Minato-J/EDT/README.md

# 2026 年全国大学生电子设计竞赛 — 智能小车循迹系统

## 📋 项目概述

本项目为 2026 年全国大学生电子设计竞赛（武汉工程大学校内选拔赛）智能小车参赛作品。小车以 **STM32F407VET6** 为主控芯片，**K230 摄像头模组**进行视觉循迹，**JY901S 陀螺仪**实现姿态保持与航向角闭环控制，通过 **TB6612** 双路电机驱动芯片控制双轮差速小车，沿指定路线自动行驶。

### 赛道场地布局

```
                          A ——————————— B
                         /                \
                        /                  \
                       /                    \
                      |                      |
                      |      场地尺寸          |
                      |   220cm × 120cm      |
                      |   圆弧半径 R=40cm     |
                      |                      |
                       \                    /
                        \                  /
                         \                /
                          D ——————————— C
```

| 参数 | 数值 |
|---|---|
| 外框总长度 | 220 cm |
| 外框总宽度 | 120 cm |
| 圆弧半径 | 40 cm |
| 顶部直线 AB 距离 | 100 cm |
| 圆心距边界 | 右侧圆心距右边界 60cm，距下边界 60cm（中轴线上） |

### 竞赛任务

| 任务 | 路线 | 状态 |
|---|---|:----:|
| 任务(1) | A→B 直线行驶 | ✅ 已完成 |
| 任务(2) | A→B→C→D→A 完整一圈 | 🔧 框架已搭建 (~40%) |
| 任务(3) | A→C→B→D→A 交叉路径 | 🔧 初期开发 (~10%) |
| 任务(4) | 多圈连续行驶 + 精确停车 | ⏳ 未开始 (0%) |

---

## 🧩 系统总体框图

```
┌──────────────────────────────────────────────────────────────────────────┐
│                            系统总体架构                                    │
└──────────────────────────────────────────────────────────────────────────┘

┌──────────────────┐                         ┌──────────────────┐
│   K230 摄像头     │                         │   JY901S 陀螺仪   │
│   视觉感知模块     │                         │   姿态感知模块     │
│                  │                         │                  │
│  • 640×480 RGB   │    UART3 (115200bps)    │  • 3轴加速度计    │    UART2 (9600bps)
│  • 6路ROI灰度检测 │ ◄──────────────────────►│  • 3轴陀螺仪      │ ◄──────────────────────►
│  • 黑线阈值=30   │    3字节数据包           │  • 3轴角度(RPY)   │    11字节数据包
│  • MicroPython   │    [0xAA,0x55,data]     │  • 波特率9600     │    [0x55,type,6B+chk]
└──────────────────┘                         └──────────────────┘
         │                                            │
         │  6-bit 黑线位图                            │  Yaw/Roll/Pitch 角度
         │  (每bit代表1路ROI的黑/白)                    │
         │                                            │
         ▼                                            ▼
┌──────────────────────────────────────────────────────────────────────────┐
│                        STM32F407VET6 主控制器                             │
│                        ARM Cortex-M4 @ 168MHz                            │
│                                                                          │
│  ┌─────────────────────────────────────────────────────────────────┐   │
│  │                     TIM6 中断服务程序 (20ms)                       │   │
│  │                                                                   │   │
│  │  ┌──────────┐  ┌──────────┐  ┌──────────┐  ┌──────────┐        │   │
│  │  │ 按键扫描  │  │ 节点检测  │  │ 角度过滤  │  │ 双模切换  │        │   │
│  │  │ (PB0/PC12)│  │ (黑线边沿)│  │ (>30°丢弃)│  │ 策略选择  │        │   │
│  │  └──────────┘  └──────────┘  └──────────┘  └────┬─────┘        │   │
│  │                                                 │               │   │
│  │                    ┌────────────────────────────┴──────┐        │   │
│  │                    │  line_sensor_data                  │        │   │
│  │                    ▼                                    ▼        │   │
│  │        ┌──────────────────┐              ┌──────────────────┐    │   │
│  │        │  模式A: 盲开模式  │              │  模式B: 循迹模式  │    │   │
│  │        │  (无黑线可见时)   │              │  (检测到黑线时)   │    │   │
│  │        │  target_angle    │              │  K230转弯量+      │    │   │
│  │        │  驱动角度环PID    │              │  速度环PID修正    │    │   │
│  │        └────────┬─────────┘              └────────┬─────────┘    │   │
│  │                 │                                 │              │   │
│  │                 └────────────┬────────────────────┘              │   │
│  │                              ▼                                    │   │
│  │              ┌─────────────────────────────┐                     │   │
│  │              │  增量式 PID 速度环 × 2        │                     │   │
│  │              │  左轮: Kp=0.9 Ki=0.12        │                     │   │
│  │              │  右轮: Kp=0.8 Ki=0.12        │                     │   │
│  │              │  + 角度环 PD (Kp=0.8 Kd=0.9) │                     │   │
│  │              └──────────────┬──────────────┘                     │   │
│  │                             │                                    │   │
│  │              ┌──────────────┴──────────────┐                     │   │
│  │              │  编码器速度反馈 (低通滤波)    │                     │   │
│  │              │  filtered=0.7×prev+0.3×raw  │                     │   │
│  │              └─────────────────────────────┘                     │   │
│  └─────────────────────────────────────────────────────────────────┘   │
│                                                                          │
│  ┌──────────────────────────────────────────────────────────────────┐   │
│  │                      任务状态机 (主循环)                           │   │
│  │  Task1: count触发  │  Task2: count触发  │  Task3: state机(9态)   │   │
│  │  A→B直线→停车      │  A→B→C→D→A一圈     │  A→C→B→D→A交叉        │   │
│  └──────────────────────────────────────────────────────────────────┘   │
└──────────────────────────────────────────────────────────────────────────┘
         │                                │
         │ PWM (PA6/PA7)                  │ 编码器脉冲
         │ TIM3 CH1/CH2                   │ TIM2(左) TIM4(右)
         │ 20kHz                          │ 4倍频计数
         ▼                                ▼
┌──────────────────────────────────────────────────────────────────────────┐
│                          电机驱动与执行层                                  │
│                                                                          │
│  ┌──────────────┐   ┌──────────────┐   ┌──────────────┐                 │
│  │  TB6612 驱动  │   │  左轮电机     │   │  右轮电机     │                 │
│  │  STBY + AINx  │   │  TT直流电机   │   │  TT直流电机   │                 │
│  │  + BINx + PWM │   │  编码器 ×2    │   │  编码器 ×2    │                 │
│  └──────────────┘   └──────────────┘   └──────────────┘                 │
│                                                                          │
│  ┌──────────────┐   ┌──────────────┐   ┌──────────────┐                 │
│  │  OLED 显示    │   │  LED + 蜂鸣器 │   │  按键输入     │                 │
│  │  软件I2C      │   │  状态指示     │   │  任务选择/启动 │                 │
│  │  PB6/PB7      │   │  PC9/PD3     │   │  PB0/PC12    │                 │
│  └──────────────┘   └──────────────┘   └──────────────┘                 │
└──────────────────────────────────────────────────────────────────────────┘
```

---

## ⚙️ 电机驱动子系统

### 子系统框图

```
┌─────────────────────────────────────────────────────────────────────┐
│                       电机驱动子系统架构                               │
└─────────────────────────────────────────────────────────────────────┘

                        ┌──────────────────────┐
                        │   STM32F407VET6      │
                        │   主控制器             │
                        │                      │
                        │  ┌────────────────┐  │
                        │  │  PID 速度环     │  │
                        │  │  left  right   │  │
                        │  │  输出: ±500    │  │
                        │  └───┬────────┬───┘  │
                        │      │        │      │
                        │  ┌───┴──┐ ┌──┴────┐  │
                        │  │ PWM  │ │ PWM   │  │
                        │  │ CH1  │ │ CH2   │  │
                        │  │ PA6  │ │ PA7   │  │
                        │  └──┬───┘ └──┬────┘  │
                        └─────┼────────┼───────┘
                              │        │
                    ┌─────────┼────────┼─────────┐
                    │         ▼        ▼         │
                    │  ┌─────────────────────┐   │
                    │  │     TB6612FNG       │   │
                    │  │   双路H桥电机驱动    │   │
                    │  │                     │   │
      VM (7.4V) ────┤──│ VM          VCC ────┼───┤── 5V (STM32)
                    │  │                     │   │
                    │  │ PWMA ─── PA6 (TIM3) │   │
                    │  │ AIN1 ─── PE2 (GPIO) │   │
                    │  │ AIN2 ─── PE3 (GPIO) │   │
                    │  │                     │   │
                    │  │ PWMB ─── PA7 (TIM3) │   │
                    │  │ BIN1 ─── PE4 (GPIO) │   │
                    │  │ BIN2 ─── PE5 (GPIO) │   │
                    │  │                     │   │
                    │  │ STBY ─── PE6 (GPIO) │   │
                    │  │ GND ──── GND        │   │
                    │  └────────┬────────────┘   │
                    │           │                │
                    │     ┌─────┴─────┐          │
                    │     ▼           ▼          │
                    │  ┌──────┐  ┌──────┐        │
                    │  │ 左轮  │  │ 右轮  │        │
                    │  │ M1    │  │ M2    │        │
                    │  │ TT电机│  │ TT电机│        │
                    │  └──┬───┘  └──┬───┘        │
                    │     │         │            │
                    │  ┌──┴─────────┴──┐         │
                    │  │  霍尔编码器    │         │
                    │  │  A相 + B相     │         │
                    │  └──┬─────────┬──┘         │
                    │     │         │            │
                    └─────┼─────────┼────────────┘
                          │         │
                    ┌─────┼─────────┼────────────┐
                    │     ▼         ▼            │
                    │  TIM2_CH1  TIM4_CH1        │
                    │  PA0       PD12            │
                    │  TIM2_CH2  TIM4_CH2        │
                    │  PA1       PD13            │
                    │  STM32 编码器接口           │
                    │  4倍频 脉冲计数             │
                    └────────────────────────────┘
```

### 电机驱动电路原理图

```
                        TB6612FNG 电机驱动电路
                        ═══════════════════════

                              VM (电池 7.4V)
                               │
                              ─┼─ C1
                              ─┼─ 100μF/25V
                               │ 电解电容
                              ─┼─ C2
                              ─┼─ 0.1μF
                               │ 陶瓷电容
                               │
            ┌──────────────────┼──────────────────────┐
            │                  │                      │
            │    ┌─────────────┴─────────────┐        │
            │    │          TB6612FNG         │        │
            │    │                            │        │
    5V ─────┼────│ 1  VCC           VM    24 │────────┼── VM
            │    │                            │        │
    5V ─────┼────│ 2  VCC           GND   23 │────────┼── GND
            │    │                            │        │
    GND ────┼────│ 3  GND          PWMB   22 │────────┼── PA7 (TIM3_CH2)
            │    │                            │        │
            │    │                   BIN2  21 │────────┼── PE5
 PA6 ──────┼────│ 4  PWMA          BIN1  20 │────────┼── PE4
 (TIM3_CH1)│    │                            │        │
            │    │                   STBY  19 │────────┼── PE6
 PE2 ──────┼────│ 5  AIN1           VCC   18 │────────┼── 5V
            │    │                            │        │
 PE3 ──────┼────│ 6  AIN2           GND   17 │────────┼── GND
            │    │                            │        │
            │    │                  AO2   16 │────────┼── 左电机 (+)
  左电机 ───┼────│ 7  AO1           AO2   15 │────────┼── 左电机 (-)
  M1       │    │                            │        │
            │    │                  BO2   14 │────────┼── 右电机 (+)
  右电机 ───┼────│ 8  BO1           BO2   13 │────────┼── 右电机 (-)
  M2       │    │                            │        │
            │    │                  GND   12 │────────┼── GND
            │    │                  VM    11 │────────┼── VM
            │    └────────────────────────────┘        │
            │                                          │
            └──────────────────────────────────────────┘

            控制真值表:
            ╔══════╤══════╤══════╤══════════════╗
            ║ AIN1 │ AIN2 │ PWMA │  电机状态     ║
            ╠══════╪══════╪══════╪══════════════╣
            ║  1   │  0   │  X   │  正转 (前进)  ║
            ║  0   │  1   │  X   │  反转 (后退)  ║
            ║  0   │  0   │  X   │  刹车         ║
            ║  1   │  1   │  X   │  刹车         ║
            ╚══════╧══════╧══════╧══════════════╝

            STBY = 1: 正常工作
            STBY = 0: 待机(电机停转)

            PWM频率: 20kHz (TIM3: PSC=83, ARR=99, 168MHz/84/100)
```

### 编码器速度反馈电路

```
                     编码器接口电路
                     ═══════════════

    左轮编码器                            右轮编码器
    ┌─────────┐                          ┌─────────┐
    │ 霍尔编码器│                          │ 霍尔编码器│
    │ A相  B相 │                          │ A相  B相 │
    └──┬───┬──┘                          └──┬───┬──┘
       │   │                                │   │
       ▼   ▼                                ▼   ▼
    ┌──────────┐                         ┌──────────┐
    │ 上拉电阻  │                         │ 上拉电阻  │
    │ 10kΩ ×2  │                         │ 10kΩ ×2  │
    └────┬─────┘                         └────┬─────┘
         │                                    │
    ┌────┴────┐                          ┌────┴────┐
    ▼         ▼                          ▼         ▼
   PA0      PA1                        PD12      PD13
  TIM2_CH1 TIM2_CH2                  TIM4_CH1  TIM4_CH2
    │         │                          │         │
    └────┬────┘                          └────┬────┘
         ▼                                    ▼
    ┌──────────────────┐              ┌──────────────────┐
    │ TIM2 编码器模式    │              │ TIM4 编码器模式    │
    │ TI12 4倍频        │              │ TI12 4倍频        │
    │ 周期=20ms读取一次  │              │ 周期=20ms读取一次  │
    │ 读后清零          │              │ 读后清零          │
    └──────────────────┘              └──────────────────┘
         │                                    │
         └────────────┬───────────────────────┘
                      ▼
              ┌───────────────┐
              │ 低通滤波       │
              │ filt = 0.7×old│
              │      + 0.3×new│
              └───────┬───────┘
                      ▼
              ┌───────────────┐
              │ PID 速度环输入 │
              │  target vs    │
              │  filtered     │
              └───────────────┘
```

### 电机驱动关键参数

| 参数 | 数值 | 说明 |
|---|:----:|---|
| PWM 频率 | 20 kHz | 超声频段，无啸叫 |
| PWM 分辨率 | 100 级 | ARR=99，占空比 1% 步进 |
| 速度输出范围 | -1000 ~ +1000 | 软件钳位，正=前进 |
| 左轮 PID Kp | 0.9 | 速度环比例增益 |
| 左轮 PID Ki | 0.12 | 速度环积分增益 |
| 右轮 PID Kp | 0.8 | 速度环比例增益 |
| 右轮 PID Ki | 0.12 | 速度环积分增益 |
| 角度环 Kp | 0.8 | 航向角比例增益 |
| 角度环 Kd | 0.9 | 航向角微分增益 |
| 编码器分辨率 | 4倍频 | TI12模式，双通道双沿 |

---

## 👁️ 视觉循迹子系统

### 子系统框图

```
┌─────────────────────────────────────────────────────────────────────┐
│                      视觉循迹子系统架构                               │
└─────────────────────────────────────────────────────────────────────┘

┌─────────────────────────────────────────────────────┐
│                  K230 摄像头模组                      │
│                                                     │
│  ┌───────────────────────────────────────────────┐  │
│  │             OV5647 图像传感器                   │  │
│  │            1280×960 → 640×480 RGB565          │  │
│  └────────────────────┬──────────────────────────┘  │
│                       │                              │
│                       ▼                              │
│  ┌───────────────────────────────────────────────┐  │
│  │          MicroPython 图像处理流水线              │  │
│  │                                               │  │
│  │   640×480 画面分割为 6 个 ROI 区域:             │  │
│  │                                               │  │
│  │  ┌──────┬──────┬──────┬──────┬──────┬──────┐  │  │
│  │  │ ROI0 │ ROI1 │ ROI2 │ ROI3 │ ROI4 │ ROI5 │  │  │
│  │  │ 106px│ 106px│ 106px│ 106px│ 106px│ 110px│  │  │
│  │  │      │      │      │      │      │      │  │  │
│  │  │ 位5  │ 位4  │ 位3  │ 位2  │ 位1  │ 位0  │  │  │
│  │  │ MSB  │      │      │      │      │ LSB  │  │  │
│  │  └──────┴──────┴──────┴──────┴──────┴──────┘  │  │
│  │         y=360, h=60px (画面下部)               │  │
│  │                                               │  │
│  │  每个 ROI: 计算平均灰度 → 阈值判断(30)          │  │
│  │  灰度 < 30 → 黑线 → bit=1                      │  │
│  │  灰度 ≥ 30 → 白底 → bit=0                      │  │
│  └────────────────────┬──────────────────────────┘  │
│                       │                              │
│                       ▼                              │
│  ┌───────────────────────────────────────────────┐  │
│  │        UART 发送 (115200bps, 8N1)             │  │
│  │        3字节数据包: [0xAA, 0x55, data]         │  │
│  │        data = 6-bit 黑线位图                   │  │
│  └────────────────────┬──────────────────────────┘  │
│                       │                              │
│  ┌────────────────────┴──────────────────────────┐  │
│  │        ST7701 2.4" LCD 显示屏                  │  │
│  │        实时预览: 绿色=黑线, 红色=白底           │  │
│  └───────────────────────────────────────────────┘  │
└─────────────────────┬───────────────────────────────┘
                      │
          UART3 (115200bps, 8N1)
          PB10 (STM32 RX) ← PB11 (STM32 TX)
          K230 TX → STM32 RX
                      │
                      ▼
┌─────────────────────────────────────────────────────┐
│              STM32F407VET6 视觉数据处理               │
│                                                     │
│  ┌───────────────────────────────────────────────┐  │
│  │   UART3 RX 中断 (逐字节接收)                    │  │
│  │   状态机:                                       │  │
│  │   WAIT_AA → WAIT_55 → GET_DATA → WAIT_AA      │  │
│  │   接收到 data 字节后更新 line_sensor_data       │  │
│  └────────────────────┬──────────────────────────┘  │
│                       │                              │
│                       ▼                              │
│  ┌───────────────────────────────────────────────┐  │
│  │        K230_Get_Turn_Speed()                  │  │
│  │        6-bit 位图 → 转弯量映射                  │  │
│  │                                               │  │
│  │  ┌─────────────┬──────────┬────────────────┐  │  │
│  │  │  sensor_val │  含义    │  turn_speed    │  │  │
│  │  ├─────────────┼──────────┼────────────────┤  │  │
│  │  │   0x0C      │ 正中     │      0         │  │  │
│  │  │   0x08      │ 略左偏   │     +2         │  │  │
│  │  │   0x04      │ 略右偏   │     -2         │  │  │
│  │  │   0x18      │ 中度左偏 │     +3         │  │  │
│  │  │   0x06      │ 中度右偏 │     -3         │  │  │
│  │  │   0x1C      │ 中左偏   │     +5         │  │  │
│  │  │   0x0E      │ 中右偏   │     -5         │  │  │
│  │  │   0x38      │ 强左偏   │     +6         │  │  │
│  │  │   0x07      │ 强右偏   │     -6         │  │  │
│  │  │   0x30      │ 极左偏   │    +10         │  │  │
│  │  │   0x03      │ 极右偏   │    -10         │  │  │
│  │  │   0x20      │ 最左边缘 │    +12         │  │  │
│  │  │   0x01      │ 最右边缘 │    -12         │  │  │
│  │  │   default   │ 保持上次 │  last_turn     │  │  │
│  │  └─────────────┴──────────┴────────────────┘  │  │
│  └────────────────────┬──────────────────────────┘  │
│                       │                              │
│                       ▼                              │
│  ┌───────────────────────────────────────────────┐  │
│  │        双模切换逻辑 (TIM6 中断内)               │  │
│  │                                               │  │
│  │  line_sensor_data == 0x00 ?                   │  │
│  │    ├─ YES → 模式A (盲开):                      │  │
│  │    │   角度环PID保持 target_angle               │  │
│  │    │   turn_out = angle_PID_output             │  │
│  │    │                                           │  │
│  │    └─ NO  → 模式B (循迹):                      │  │
│  │       turn_out = K230_Get_Turn_Speed(data)     │  │
│  │       转弯平滑: 0.7×old + 0.3×new              │  │
│  │       target_v_left  = base_speed - turn       │  │
│  │       target_v_right = base_speed + turn       │  │
│  └───────────────────────────────────────────────┘  │
└─────────────────────────────────────────────────────┘
```

### K230 视觉处理电路原理图

```
                    K230 摄像头模组接线图
                    ═════════════════════

┌─────────────────────────────────────────────────────────────────┐
│                      K230 开发板                                 │
│                                                                 │
│   ┌───────────────────────────────────────────────────────────┐ │
│   │                    K230 芯片 (RISC-V + KPU)                 │ │
│   │                                                           │ │
│   │  ┌────────────────┐        ┌────────────────┐            │ │
│   │  │  OV5647 摄像头   │  CSI   │  图像处理流水线  │            │ │
│   │  │  640×480@30fps  │───────►│  6×ROI 灰度检测 │            │ │
│   │  └────────────────┘        └───────┬────────┘            │ │
│   │                                    │                      │ │
│   │                          ┌─────────┴─────────┐            │ │
│   │                          ▼                     ▼          │ │
│   │                   ┌────────────┐       ┌────────────┐     │ │
│   │                   │ UART 发送   │       │ LCD 显示    │     │ │
│   │                   │ 115200bps  │       │ ST7701 2.4"│     │ │
│   │                   │ TX         │       │ 实时预览    │     │ │
│   │                   └─────┬──────┘       └────────────┘     │ │
│   │                         │                                  │ │
│   └─────────────────────────┼──────────────────────────────────┘ │
│                             │                                    │
│                   K230 TX   │   K230 RX                          │
│                     (发送)   │   (接收)                           │
│                       │     │     │                              │
└───────────────────────┼─────┼─────┼──────────────────────────────┘
                        │     │     │
                        │     │     │
        ┌───────────────┼─────┼─────┼───────────────┐
        │               ▼     │     ▼               │
        │         PB10 (RX)   │   PB11 (TX)         │
        │               │     │     │               │
        │         ┌─────┴─────┼─────┴─────┐         │
        │         │   UART3    │   UART3   │         │
        │         │   RX中断   │   TX      │         │
        │         │  (115200)  │ (115200)  │         │
        │         └───────────┘ └──────────┘         │
        │                  STM32F407VET6              │
        └────────────────────────────────────────────┘

        通信协议:
        ╔═══════╤═══════╤═════════════╤══════════════════════╗
        ║ Byte0 │ Byte1 │   Byte2     │        说明           ║
        ╠═══════╪═══════╪═════════════╪══════════════════════╣
        ║ 0xAA  │ 0x55  │ sensor_data │ 帧头固定, data=6位位图 ║
        ╚═══════╧═══════╧═════════════╧══════════════════════╝

        data 位定义:
        ╔═══════╤═══════╤═══════╤═══════╤═══════╤═══════╗
        ║ Bit 5 │ Bit 4 │ Bit 3 │ Bit 2 │ Bit 1 │ Bit 0 ║
        ║ ROI 0 │ ROI 1 │ ROI 2 │ ROI 3 │ ROI 4 │ ROI 5 ║
        ║ 最左  │       │       │       │       │ 最右  ║
        ╚═══════╧═══════╧═══════╧═══════╧═══════╧═══════╝
        1 = 检测到黑线, 0 = 白底
```

### 视觉循迹关键参数

| 参数 | 数值 | 说明 |
|---|:----:|---|
| 图像分辨率 | 640×480 | RGB565 格式 |
| ROI 数量 | 6 路 | 均匀分布画面下方 |
| ROI 尺寸 | 106×60 px | 每路 (最右 110px) |
| ROI Y 位置 | y=360 | 画面下方 3/4 处 |
| 黑线阈值 | 30 | 平均灰度 < 30 判定为黑 |
| 通信波特率 | 115200 bps | UART3 |
| 数据包长度 | 3 字节 | [0xAA, 0x55, data] |
| 转弯量范围 | -12 ~ +12 | 正值=左转，负值=右转 |
| 转弯平滑系数 | 0.3 | 一阶低通滤波 |
| 盲开判定条件 | data == 0x00 | 所有 ROI 均为白色 |

---

## 🔧 JY901S 陀螺仪姿态子系统

### 通信协议

```
            JY901S 数据帧格式 (11字节)
            ══════════════════════════

    ┌──────┬──────┬──────┬──────┬──────┬──────┬──────┬──────┬──────┬──────┬──────┐
    │ Byte0│ Byte1│ Byte2│ Byte3│ Byte4│ Byte5│ Byte6│ Byte7│ Byte8│ Byte9│Byte10│
    ├──────┼──────┼──────┼──────┼──────┼──────┼──────┼──────┼──────┼──────┼──────┤
    │ 0x55 │ Type │  XL  │  XH  │  YL  │  YH  │  ZL  │  ZH  │  TL  │  TH  │ SUM  │
    └──────┴──────┴──────┴──────┴──────┴──────┴──────┴──────┴──────┴──────┴──────┘
     帧头    类型    数据低字节  数据高字节  ...  ...  ...  ...  温度低  温度高  校验和

    校验: SUM = Byte0+Byte1+...+Byte9 (低8位)

    数据封装:
    ╔══════╤══════════════╤═══════════════════════╤═════════════════════════╗
    ║ Type │    数据含义    │       计算公式         │         单位             ║
    ╠══════╪══════════════╪═══════════════════════╪═════════════════════════╣
    ║ 0x51 │ 加速度 Ax/Ay/Az│ (short)(XH<<8|XL)/32768×16 │        g             ║
    ║ 0x52 │ 角速度 Gx/Gy/Gz│ (short)(XH<<8|XL)/32768×2000│      deg/s          ║
    ║ 0x53 │ 角度 R/P/Y    │ (short)(XH<<8|XL)/32768×180 │      degree         ║
    ╚══════╧══════════════╧═══════════════════════╧═════════════════════════╝
```

### 角度数据处理流程

```
    USART2 RX中断 (9600bps)
    ┌─────────────────────────┐
    │  WIT_Parse_Byte(byte)   │
    │  状态机逐字节解析         │
    │  0x55 → 累计11字节       │
    │  校验通过 → 解码         │
    └────────────┬────────────┘
                 │
                 ▼
    ┌─────────────────────────┐
    │  IMU_Data.Yaw (原始值)   │
    │  范围: -180° ~ +180°    │
    └────────────┬────────────┘
                 │
                 ▼
    ┌─────────────────────────┐
    │  偏移校准                 │
    │  Yaw -= Yaw_Offset      │
    │  (启动时记录初始航向)      │
    └────────────┬────────────┘
                 │
                 ▼
    ┌─────────────────────────┐
    │  角度突变过滤             │
    │  |ΔYaw| > 30°/20ms      │
    │  → 丢弃本次读数           │
    └────────────┬────────────┘
                 │
                 ▼
    ┌─────────────────────────┐
    │  角度归一化               │
    │  折入 [-180°, 180°]     │
    └────────────┬────────────┘
                 │
                 ▼
    ┌─────────────────────────┐
    │  角度环 PID              │
    │  error = target - yaw   │
    │  Kp=0.8, Kd=0.9         │
    │  输出范围: ±40           │
    └─────────────────────────┘
```

---

## 📐 软件控制架构

### 数据流总览

```
     ┌──────────────────────────────────────────────────────────────┐
     │                      主循环 (while)                           │
     │                                                              │
     │  ┌─────────────┐   ┌──────────────┐   ┌──────────────────┐  │
     │  │ OLED 刷新    │   │ 任务调度      │   │ 调试 printf      │  │
     │  │ (500ms周期)  │   │ Run_Task_N() │   │ (可选, USART1)   │  │
     │  └─────────────┘   └──────────────┘   └──────────────────┘  │
     └──────────────────────────────────────────────────────────────┘
                                 │
                                 ▼
     ┌──────────────────────────────────────────────────────────────┐
     │                 TIM6 中断 (20ms = 50Hz)                       │
     │                                                              │
     │  ┌──────────┐                                                │
     │  │ 按键扫描  │──► 任务选择(PB0) / 启动(PC12)                   │
     │  └──────────┘                                                │
     │       │                                                      │
     │       ▼                                                      │
     │  ┌──────────┐                                                │
     │  │ 节点计数  │──► 黑线边沿检测 → count++ (300ms去抖)            │
     │  └──────────┘                                                │
     │       │                                                      │
     │       ▼                                                      │
     │  ┌──────────────────────────────────────────────────────┐    │
     │  │              双模切换 (核心策略)                       │    │
     │  │                                                      │    │
     │  │  line_sensor_data == 0x00 ?                          │    │
     │  │  ┌───────────────────┐    ┌───────────────────────┐  │    │
     │  │  │  模式A: 盲开      │    │  模式B: 视觉循迹       │  │    │
     │  │  │                  │    │                       │  │    │
     │  │  │ 角度环PID控制    │    │ K230转弯量映射        │  │    │
     │  │  │ 保持target_angle │    │ turn→微分速度差分配   │  │    │
     │  │  │ PID输出→turn_out │    │ turn_out=平滑滤波     │  │    │
     │  │  └───────────────────┘    └───────────────────────┘  │    │
     │  └──────────────────────────┬───────────────────────────┘    │
     │                             │                                │
     │                             ▼                                │
     │  ┌──────────────────────────────────────────────────────┐    │
     │  │              差速分解                                  │    │
     │  │  target_v_left  = base_speed - turn_out_smooth       │    │
     │  │  target_v_right = base_speed + turn_out_smooth       │    │
     │  └──────────────────────────┬───────────────────────────┘    │
     │                             │                                │
     │              ┌──────────────┴──────────────┐                 │
     │              ▼                             ▼                 │
     │  ┌──────────────────┐          ┌──────────────────┐         │
     │  │ 左轮速度环PID     │          │ 右轮速度环PID     │         │
     │  │ Kp=0.9 Ki=0.12   │          │ Kp=0.8 Ki=0.12   │         │
     │  │ target=target_vl │          │ target=target_vr │         │
     │  │ measured=enc_left│          │ measured=enc_right│        │
     │  └────────┬─────────┘          └────────┬─────────┘         │
     │           │                             │                   │
     │           ▼                             ▼                   │
     │  ┌──────────────────┐          ┌──────────────────┐         │
     │  │ Motor_SetSpeed_A │          │ Motor_SetSpeed_B │         │
     │  │ → TIM3 CCR1     │          │ → TIM3 CCR2     │         │
     │  └──────────────────┘          └──────────────────┘         │
     └──────────────────────────────────────────────────────────────┘
```

### PID 控制器

```
                    增量式 PID 控制器结构
                    ═════════════════════

                ┌─────────┐
     target ────┤  +      ├────► error ────┬──────────────┐
                └────▲────┘                │              │
                     │                     ▼              ▼
                ┌────┴────┐         ┌──────────┐   ┌──────────┐
                │ measured │         │  P 项     │   │  I 项     │
                │ (编码器) │         │ Kp×error │   │ Ki×∫error│
                └─────────┘         └─────┬────┘   └─────┬────┘
                                          │              │
                                          ▼              ▼
                                    ┌──────────┐   ┌──────────┐
                                    │  D 项     │   │ 输出钳位  │
                                    │Kd×Δerror │   │  ±out_max │
                                    └─────┬────┘   └─────┬────┘
                                          │              │
                                          └──────┬───────┘
                                                 ▼
                                           ┌──────────┐
                                           │  output  │
                                           │→ PWM占空比│
                                           └──────────┘
```

---

## 🔌 完整引脚分配表

| 引脚 | 功能 | 模式 | 连接目标 |
|---|---|:----:|---|
| **PA0** | TIM2_CH1 | AF PP | 左轮编码器 A 相 |
| **PA1** | TIM2_CH2 | AF PP | 左轮编码器 B 相 |
| **PA2** | USART2_TX | AF PP | JY901S IMU RX |
| **PA3** | USART2_RX | AF PP | JY901S IMU TX |
| **PA6** | TIM3_CH1 | AF PP | TB6612 PWMA (左电机) |
| **PA7** | TIM3_CH2 | AF PP | TB6612 PWMB (右电机) |
| **PA9** | USART1_TX | AF PP | 调试串口 TX |
| **PA10** | USART1_RX | AF PP | 调试串口 RX |
| **PB0** | GPIO Input | Pull-up | 按键0 (任务选择) |
| **PB6** | GPIO Output OD | Pull-up | OLED SCL (软件I2C) |
| **PB7** | GPIO Output OD | Pull-up | OLED SDA (软件I2C) |
| **PB10** | USART3_TX | AF PP | K230 RX |
| **PB11** | USART3_RX | AF PP | K230 TX |
| **PC9** | GPIO Output PP | — | LED 指示灯 |
| **PC12** | GPIO Input | Pull-up | 按键1 (启动) |
| **PD3** | GPIO Output PP | — | 蜂鸣器 |
| **PD12** | TIM4_CH1 | AF PP | 右轮编码器 A 相 |
| **PD13** | TIM4_CH2 | AF PP | 右轮编码器 B 相 |
| **PE2** | GPIO Output PP | — | TB6612 AIN1 |
| **PE3** | GPIO Output PP | — | TB6612 AIN2 |
| **PE4** | GPIO Output PP | — | TB6612 BIN1 |
| **PE5** | GPIO Output PP | — | TB6612 BIN2 |
| **PE6** | GPIO Output PP | — | TB6612 STBY |

---

## 📁 项目目录结构

```
EDT/
├── CLAUDE.md                    # 项目 AI 开发指南
├── README.md                    # 本文件
│
├── H0/                          # 主项目 (STM32F407)
│   ├── H0.ioc                   # STM32CubeMX 配置文件
│   ├── untitled_1.py            # K230 MicroPython 视觉程序
│   │
│   ├── Core/                    # STM32CubeMX 生成代码
│   │   ├── Inc/                 # 头文件 (main.h, tim.h, usart.h, gpio.h)
│   │   └── Src/                 # 源文件 (main.c, tim.c, usart.c, gpio.c)
│   │
│   ├── Drive/                   # 用户自定义驱动层
│   │   ├── Motor.c/h            # TB6612 电机驱动
│   │   ├── encoder.c/h          # 编码器读取
│   │   ├── pid.c/h              # 增量式 PID 控制器
│   │   ├── wit_imu.c/h          # JY901S 陀螺仪解析
│   │   ├── k230_track.c/h       # K230 视觉数据解析
│   │   ├── task.c/h             # 任务状态机
│   │   ├── oled.c/h             # OLED 显示 (软件I2C)
│   │   └── led_beep.c/h         # LED + 蜂鸣器控制
│   │
│   ├── Drivers/                 # ST 官方 HAL 库
│   │   ├── CMSIS/
│   │   └── STM32F4xx_HAL_Driver/
│   │
│   └── MDK-ARM/                 # Keil MDK 工程
│       ├── H0.uvprojx           # 工程文件
│       └── startup_stm32f407xx.s
│
├── Analysis/
│   └── H0_Analysis_Report.md    # 完整项目分析报告
│
├── document/                    # 竞赛文档与模板
│   ├── 技术报告_终版.docx
│   ├── 2026电赛培训_技术报告模板/
│   └── 赛事内容/
│
└── ZIP/                         # 历史备份 (已 gitignore)
```

---

## 🚀 开发与构建

| 项目 | 说明 |
|---|---|
| **IDE** | Keil MDK (ARM Compiler 5/6) |
| **工程文件** | `H0/MDK-ARM/H0.uvprojx` |
| **主控代码** | `H0/Core/Src/main.c` |
| **K230 代码** | `H0/untitled_1.py` (MicroPython) |
| **调试串口** | USART1, 115200bps, printf 重定向 |
| **编译产物** | `H0/MDK-ARM/H0/H0.hex` / `.axf` |

### 系统时钟配置

```
    HSI 16MHz → PLL (M=8, N=168, P=2)
    → SYSCLK = 168MHz
    → AHB = 168MHz
    → APB1 = 42MHz (TIM2/3/4/6 挂载于此)
    → APB2 = 84MHz (USART1 挂载于此)
```

### 各外设时钟源

| 外设 | 总线 | 总线时钟 | 定时器时钟 | 用途 |
|---|:----:|:---:|:---:|---|
| TIM2 | APB1 | 42 MHz | 84 MHz | 左轮编码器 |
| TIM3 | APB1 | 42 MHz | 84 MHz | 电机 PWM |
| TIM4 | APB1 | 42 MHz | 84 MHz | 右轮编码器 |
| TIM6 | APB1 | 42 MHz | 84 MHz | 控制周期 (20ms) |
| USART1 | APB2 | 84 MHz | — | 调试输出 |
| USART2 | APB1 | 42 MHz | — | JY901S IMU |
| USART3 | APB1 | 42 MHz | — | K230 视觉 |

---

## 📝 参考资源

- **JY901S 数据手册**: 维特智能官方文档
- **TB6612FNG 数据手册**: 东芝双路 H 桥驱动芯片
- **STM32F407VET6 参考手册**: RM0090
- **K230 开发文档**: Canaan 官方 SDK 文档
