Minato-J/EDT/H0/Drive/led_beep.c

#include "led_beep.h"

void led_beep_init(void)
{
    GPIO_InitTypeDef GPIO_InitStruct = {0};

    /* GPIO Ports Clock Enable */
    __HAL_RCC_GPIOC_CLK_ENABLE();
    __HAL_RCC_GPIOD_CLK_ENABLE();

    /* Configure GPIO pin Output Level */
    /* LED: PC9, Default OFF (RESET) */
    HAL_GPIO_WritePin(GPIOC, GPIO_PIN_9, GPIO_PIN_RESET);
    
    /* BEEP: PD3, Default OFF (SET - Low level triggered) */
    HAL_GPIO_WritePin(GPIOD, GPIO_PIN_3, GPIO_PIN_SET);

    /* Configure GPIO pin : PC9 (LED) */
    GPIO_InitStruct.Pin = GPIO_PIN_9;
    GPIO_InitStruct.Mode = GPIO_MODE_OUTPUT_PP;
    GPIO_InitStruct.Pull = GPIO_NOPULL;
    GPIO_InitStruct.Speed = GPIO_SPEED_FREQ_LOW;
    HAL_GPIO_Init(GPIOC, &GPIO_InitStruct);

    /* Configure GPIO pin : PD3 (Beep) */
    GPIO_InitStruct.Pin = GPIO_PIN_3;
    GPIO_InitStruct.Mode = GPIO_MODE_OUTPUT_PP;
    GPIO_InitStruct.Pull = GPIO_NOPULL;
    GPIO_InitStruct.Speed = GPIO_SPEED_FREQ_LOW;
    HAL_GPIO_Init(GPIOD, &GPIO_InitStruct);
}

void Led_On(void)
{
    HAL_GPIO_WritePin(GPIOC, GPIO_PIN_9, GPIO_PIN_SET);
} 

void Led_Off(void)
{
    HAL_GPIO_WritePin(GPIOC, GPIO_PIN_9, GPIO_PIN_RESET);
}

void Beep_On(void)
{
    /* Low level triggered */
    HAL_GPIO_WritePin(GPIOD, GPIO_PIN_3, GPIO_PIN_RESET);
}

void Beep_Off(void)
{
    /* Low level triggered */
    HAL_GPIO_WritePin(GPIOD, GPIO_PIN_3, GPIO_PIN_SET);
}
