Minato-J/EDT/H0/Drive/task.h

#ifndef __TASK_H
#define __TASK_H

#include "stdint.h"


extern uint16_t selected_task;
extern uint16_t task_running;
extern uint8_t current_state;
extern uint8_t last_line_status;
extern uint8_t count;
extern float current_angle;


void Task_Manager_Init(void);
void Task_Key_Scan(void);
void key_Init(void);
void Task_Dispatcher(void);

#endif
